lolzballs/esc204/README.md

# Praxis 3

This repository is intended to be the project management software for team T20 for ESC204 at the University of Toronto.

In addition, code related to controlling our robot is hosted here.
