lolzballs/esc204/cad/PrintFeb23rd/Component1.stl

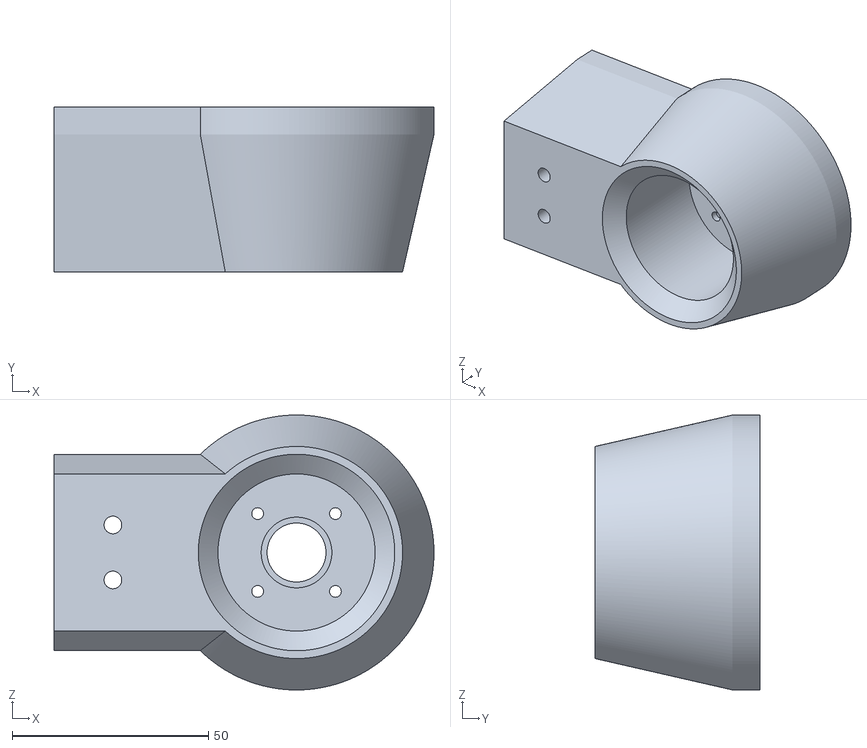
[picture p1: CAD file, 2020-03-02]
cad/PrintFeb23rd/Component1.stl
96.7 x 42.0 x 70.0
