lolzballs/esc204/cad/PrintMarch10th/TOFBracket v2.stl

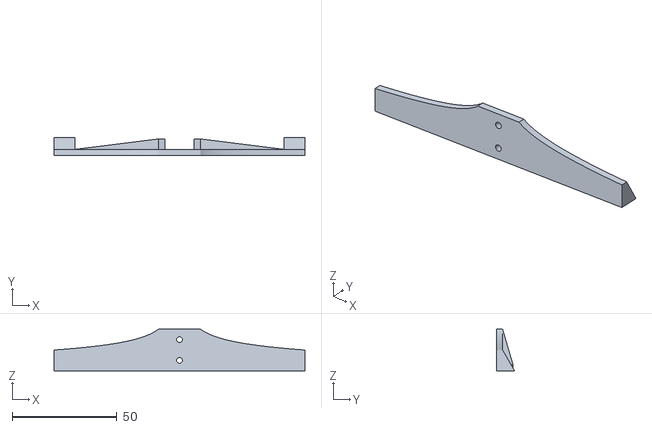
[picture p2: CAD file, 2020-03-11]
cad/PrintMarch10th/TOFBracket v2.stl
120.0 x 8.77 x 20.0
