lolzballs/esc204/cad/PrintMarch1st/JointBPartBv4.stl

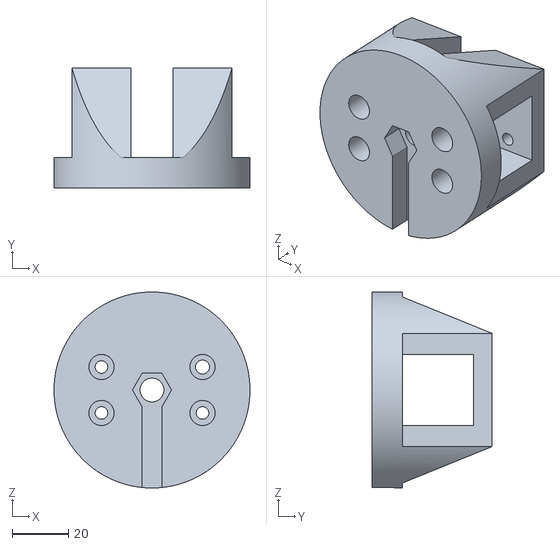
[picture p3: CAD file, 2020-03-02]
cad/PrintMarch1st/JointBPartBv4.stl
70.0 x 43.0 x 70.0
