lolzballs/esc204/cad/PrintMarch6th/JointBPartB v6.stl

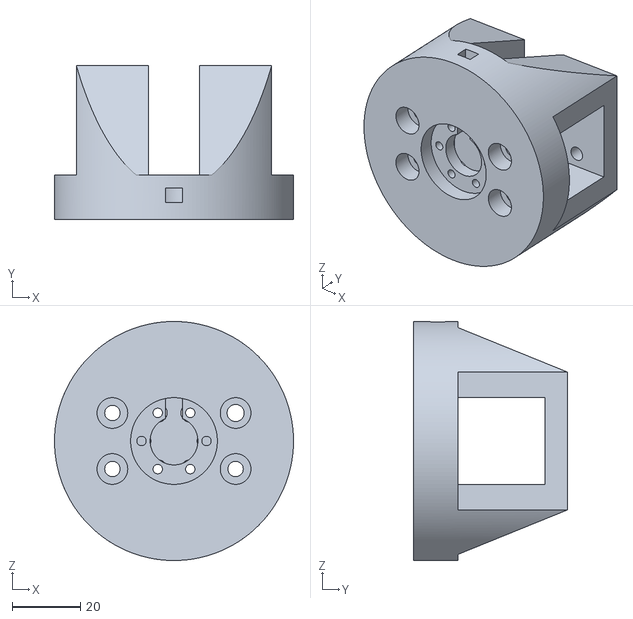
[picture p4: CAD file, 2020-03-06]
cad/PrintMarch6th/JointBPartB v6.stl
70.0 x 45.0 x 70.0
