lolzballs/esc204/cad/Protoboard_Mount v9.stl

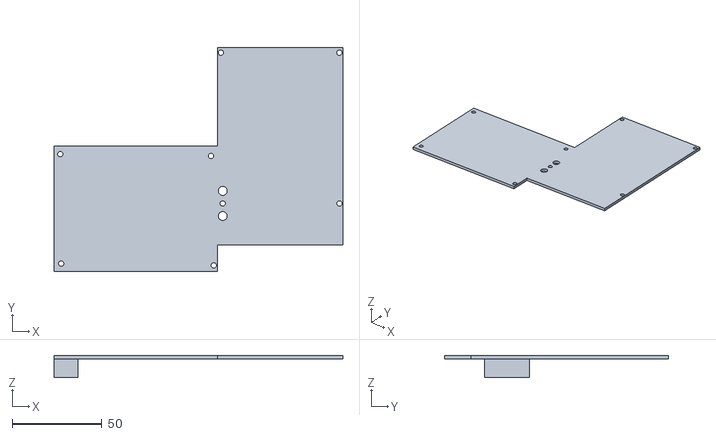
[picture p5: CAD file, 2020-03-04]
cad/Protoboard_Mount v9.stl
161.0 x 125.0 x 12.5
