lolzballs/esc204/cad/handleinterface.stl

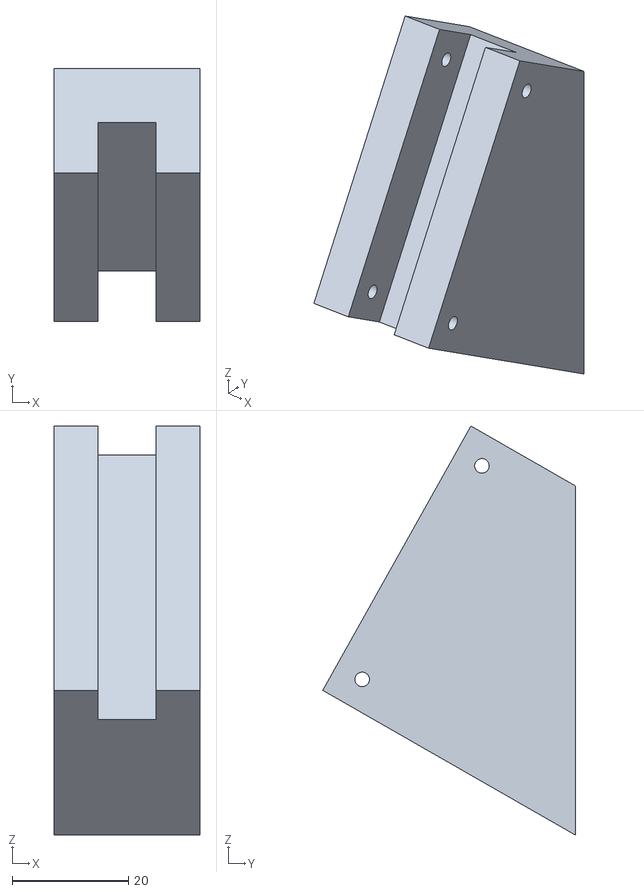
[picture p6: CAD file, 2020-03-02]
cad/handleinterface.stl
25.0 x 43.4 x 70.3
