lolzballs/esc204/cad/PrintFeb23rd/JointBPartB v4.stl

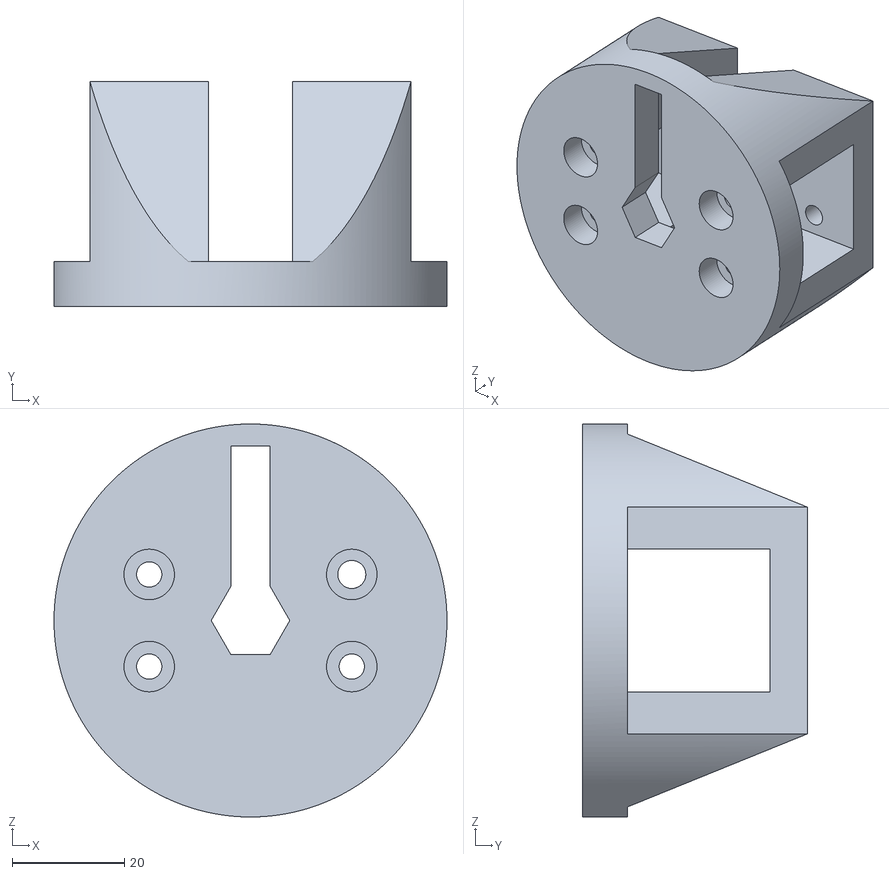
[picture p7: CAD file, 2020-03-02]
cad/PrintFeb23rd/JointBPartB v4.stl
70.0 x 40.0 x 70.0
