lolzballs/esc204/cad/PrintMarch1st/FANHolder.stl

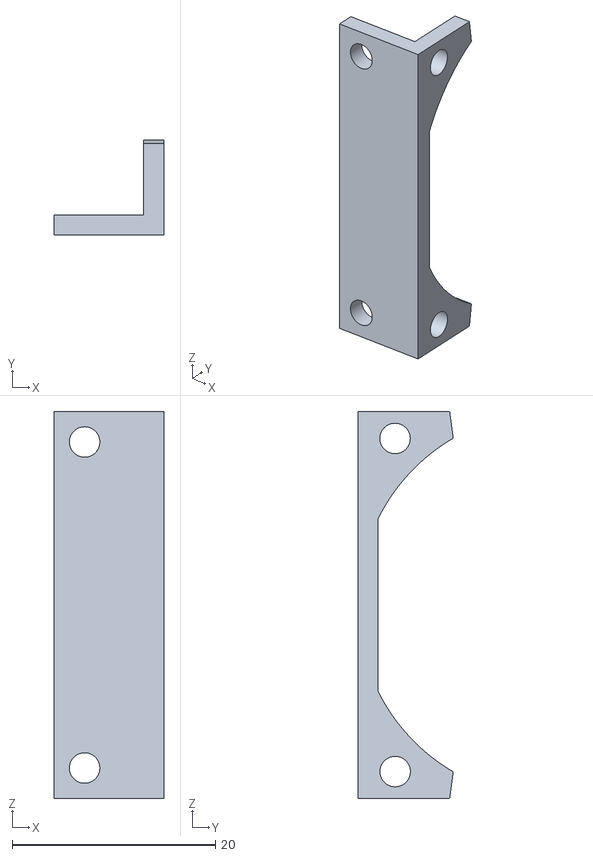
[picture p8: CAD file, 2020-03-02]
cad/PrintMarch1st/FANHolder.stl
10.8 x 9.40 x 38.1
