lolzballs/esc204/cad/PrintMarch2nd/JointBPartA v4.stl

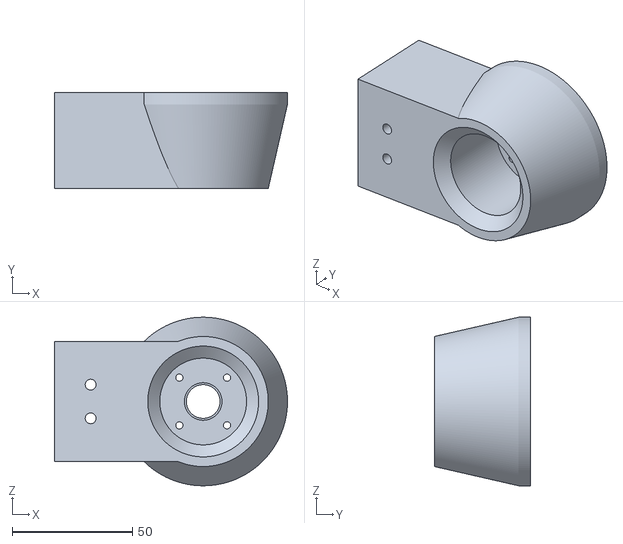
[picture p9: CAD file, 2020-03-03]
cad/PrintMarch2nd/JointBPartA v4.stl
96.7 x 40.0 x 70.0
