lolzballs/esc204/cad/PrintMarch6th/JointAInterface v4.stl

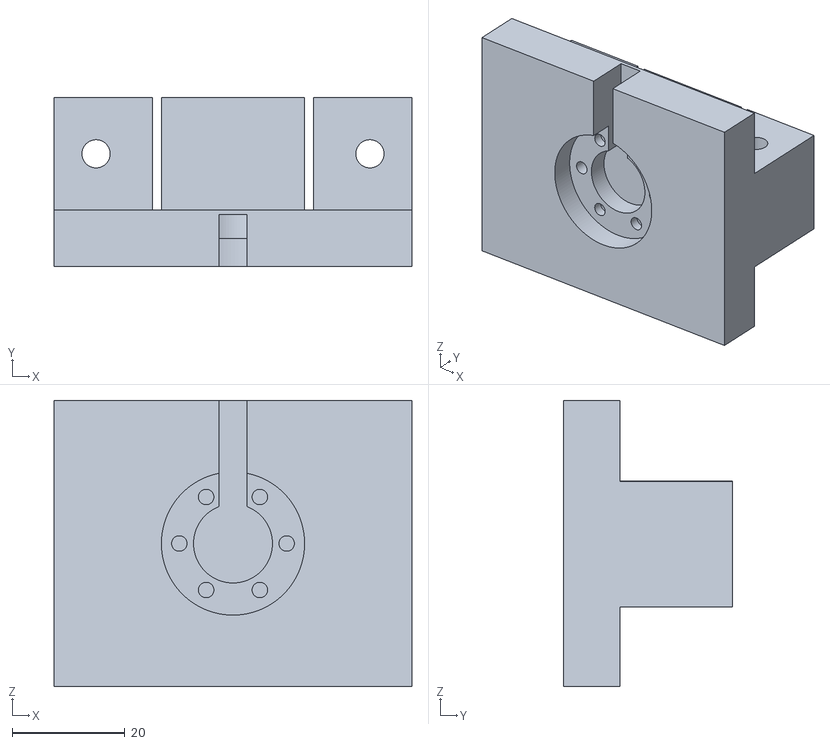
[picture p10: CAD file, 2020-03-06]
cad/PrintMarch6th/JointAInterface v4.stl
63.5 x 30.0 x 50.8
