lolzballs/esc204/cad/PrintFeb23rd/Body1.stl

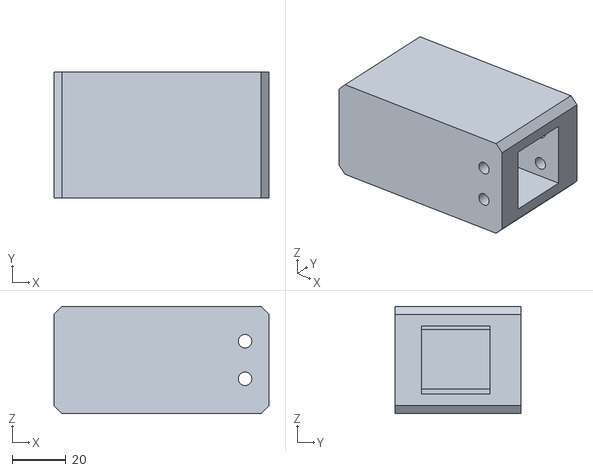
[picture p11: CAD file, 2020-03-02]
cad/PrintFeb23rd/Body1.stl
80.0 x 47.0 x 40.0
