lolzballs/esc204/cad/PrintMarch10th/CameraBracket2 v1.stl

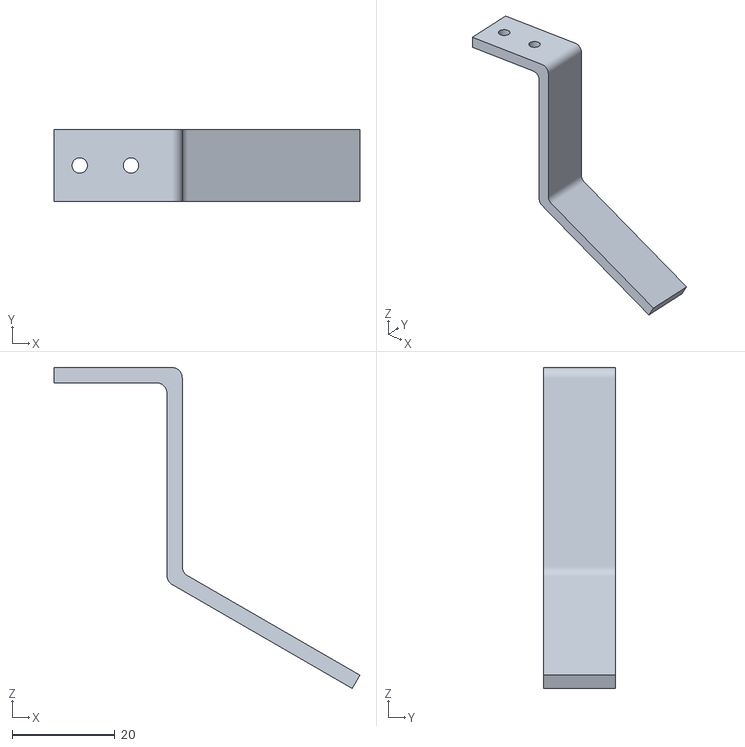
[picture p12: CAD file, 2020-03-11]
cad/PrintMarch10th/CameraBracket2 v1.stl
59.6 x 14.0 x 62.6
