lolzballs/esc204/cad/Bracket_Small_v1.stl

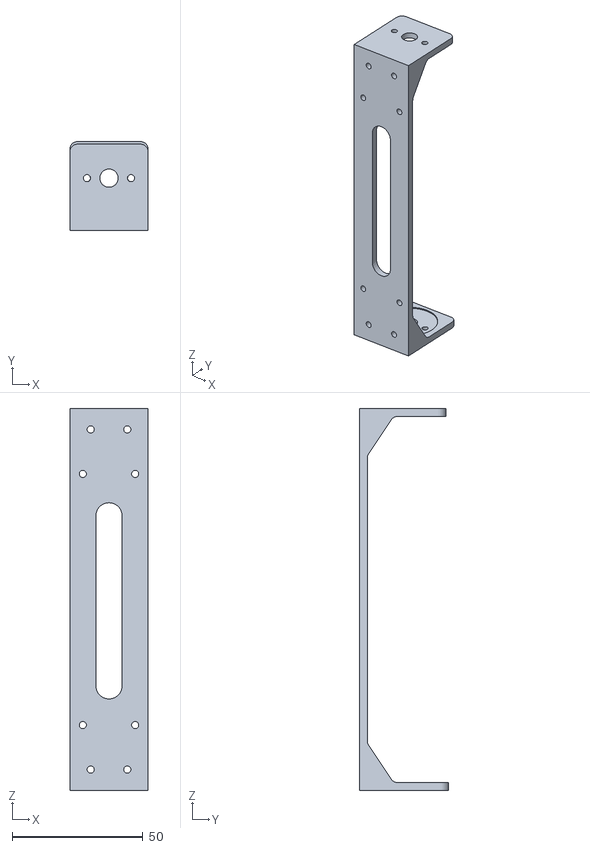
[picture p13: CAD file, 2020-03-02]
cad/Bracket_Small_v1.stl
30.0 x 34.0 x 146.0
