lolzballs/esc204/cad/PrintFeb23rd/JointAInterface v3.stl

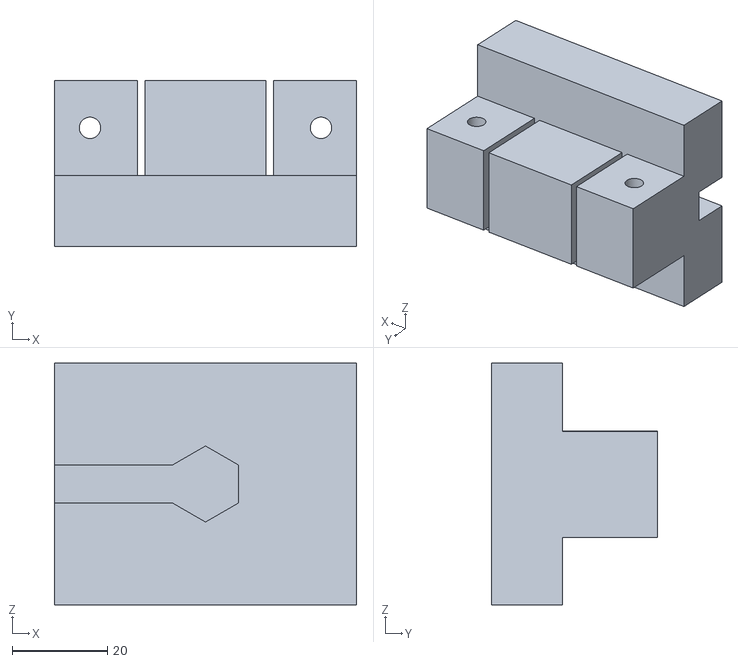
[picture p14: CAD file, 2020-03-02]
cad/PrintFeb23rd/JointAInterface v3.stl
63.5 x 35.0 x 50.8
