lolzballs/esc204/cad/PrintMarch10th/MotorBracket v1.stl

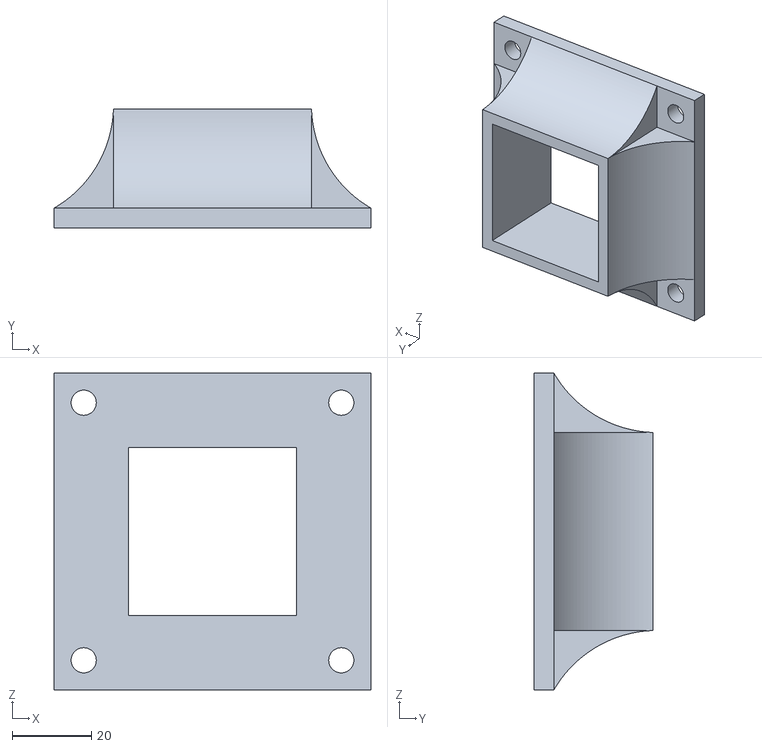
[picture p15: CAD file, 2020-03-11]
cad/PrintMarch10th/MotorBracket v1.stl
80.0 x 30.0 x 80.0
