lolzballs/esc204/cad/handlering.stl

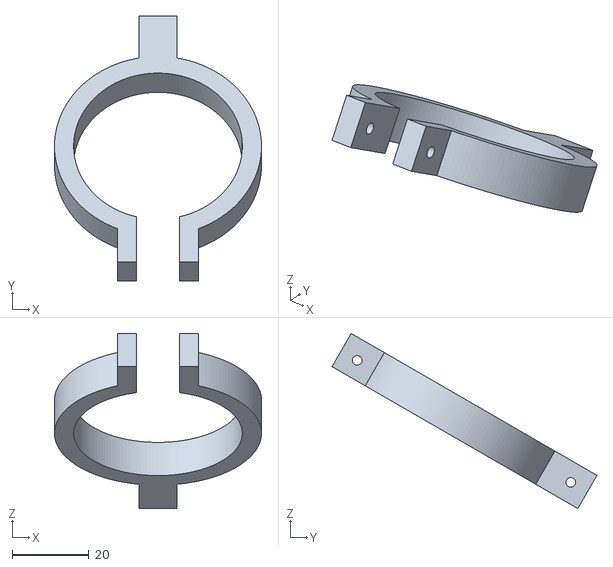
[picture p16: CAD file, 2020-03-02]
cad/handlering.stl
54.0 x 69.1 x 45.7
