lolzballs/esc204/cad/Power_Distribution_Case.stl

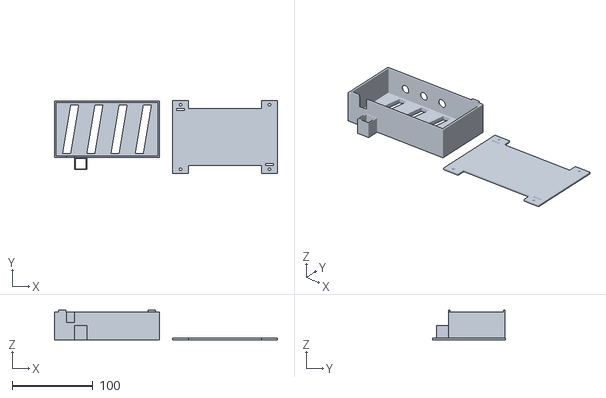
[picture p17: CAD file, 2020-03-02]
cad/Power_Distribution_Case.stl
276.1 x 90.0 x 36.7
