lolzballs/esc204/cad/JointBPartA.stl

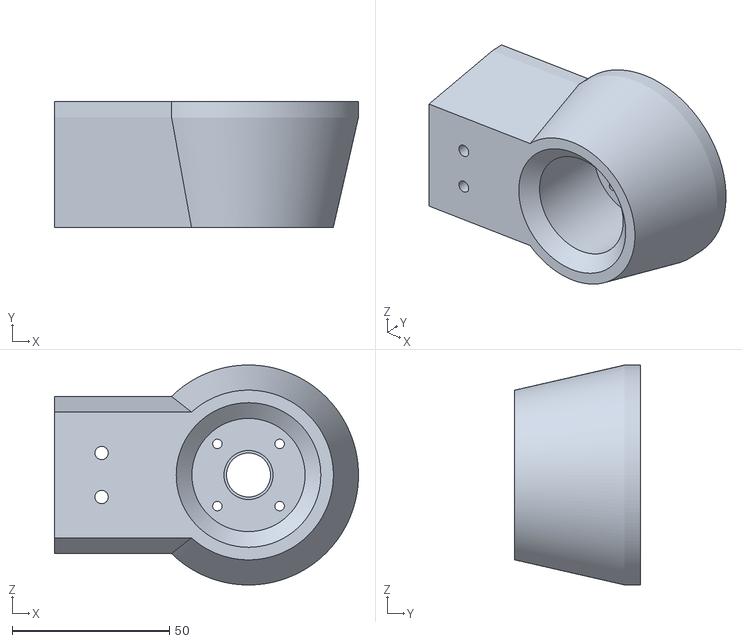
[picture p18: CAD file, 2020-03-02]
cad/JointBPartA.stl
96.7 x 40.0 x 70.0
