lolzballs/esc204/(list of files, cad)

Other CAD files:
cad/JointBPartB.stl
cad/PrintMarch10th/TOFBracket v1.stl
cad/PrintMarch2nd/JointAInterface v4.stl
cad/PrintMarch2nd/JointBPartB v6.stl
