lolzballs/esc204/(threads)

Thread 1 (2020-01-31):

Joint CAD

louisprimeau, 2020-01-31:
We need to do joint CAD, and detailed design decisions on the composition of those joints, i.e. 3D printed parts, bearings, etc.

- [x] CAD
- [x] 3D Printing

JonEsparaz, 2020-03-06:
@louisprimeau we need to modify the end-most joint's CAD to integrate the ToF sensors and camera.

JonEsparaz, 2020-03-10:
I’m going to close this issue in favour of opening a new one for CAD that can accommodate our sensors.

Closed 2020-03-10.

Thread 14 (2020-02-04):

End Effector CAD

louisprimeau, 2020-02-04:
Need to design the end effector to turn the switch on and off on the plug.

- [x] CAD
- [x] 3D Printing

louisprimeau, 2020-02-28:
Done btw

Closed 2020-02-28.

Thread 19 (2020-02-12):

Create nice wrappers for servos and steppers

lolzballs, 2020-02-12:
We want to be able to give high level commands to control the servos and steppers.

I'm thinking about having our high level logic in python, and the low-level drivers in individual C programs which can have commands sent to them through `stdio`.

JonEsparaz, 2020-02-25:
@lolzballs will `kinematics.py` interface with `commands.c`?

lolzballs, 2020-03-03:
Wrappers are done, so all that's left is the actual motion code.

Closed 2020-03-10.

Thread 22 (2020-02-19):

Power System

lolzballs, 2020-02-19:
We're using an Xbox One PSU, which provides 18A@12V and 1A@5V.

We are probably using the buck converters, since 1A can barely be used for anything.

- [x] Create power distribution board to derive power for steppers, servos and Pis
- [x] CAD enclosure
- [x] Print and install enclosure
- [x] Ensure all connections are :ok_hand:

Closed 2020-02-27.

Thread 24 (2020-02-20):

RBP camera exposure issue

JonEsparaz, 2020-02-20:
Currently the third-party RBP camera we are using requires ~ 10 seconds to properly expose an image.

Potential solutions:
- Use the genuine RBP camera (more expensive)
- Software fixes: https://projects.raspberrypi.org/en/projects/getting-started-with-picamera/7
- Live analysis from video (probably not feasible/possible)

JonEsparaz, 2020-02-28:
Conclusions after testing:
- Exposure is a non-issue if we direct light onto the test rig (requires <5 seconds)
- The OEM camera doesn't improve results
- Switching to a different colour (red or green) is likely better than blue since any windows appear blue.
- A better size filter for the rectangle detection will enure shapes in the background are not detected.

From TA: we have no guarantee of what the background will look like and won't be allowed to "calibrate" prior to testing.

JonEsparaz, 2020-03-02:
Small improvements to be made, but this specific issue is resolved.

Closed 2020-03-02.

Thread 27 (2020-03-10):

CAD for sensor mounting

JonEsparaz, 2020-03-10:
We need the mount camera and two ToF sensors. Also, not a sensor, but the second servo also needs to be mounted.

lolzballs, 2020-03-12:
The cad is complete and is printed. Just need to install now.

louisprimeau, 2020-03-12:
Cad was pushed yesterday.

Closed 2020-03-12.

Thread 28 (2020-03-10):

Motor shaft

JonEsparaz, 2020-03-10:
The set screws from our motor hubs are not sufficient to affix other components to the motor shaft (stepper motor).

lolzballs, 2020-03-10:
Since the motor hubs are circular I was thinking that rotating one of the two so that the set screw bites into the non-flat surface could help.

JonEsparaz, 2020-03-10:
I’m also wondering if we can 3D print a part that fills the empty space between the shaft and the one we wall of the hub with holes that the set screws fit into. I can CAD it up later to give you guys a better idea of what I’m thinking.

JonEsparaz, 2020-03-12:
Per in-person discussion, we are considering purchasing new stepper motors with a 6mm shaft, so that we can purchase 6mm D shaft hubs that won't slip.

lolzballs, 2020-03-12:
For now we will be using the mode of 25 missed steps to compensate. This is not ideal as we will likely be losing around 2 steps on a direction change in the base.
