lolzballs/esc204/main/milestone3.py

import kinematics
import camera

# wide scan to locate port

# align using tof w/ test rig

# move to fine scanning distance

# fine scan to centre w/ port

# check alignment

# if bad repeat alignment

# INDICATE THAT PORT HAS BEEN LOCATED

# deliver to front of port

# INDICATE THAT CHARGER HAS BEEN DELIVERED

# kill server power

# insert that mans (move forward)

# INDICATE THAT PORT HAS BEEN INSERTED

# wait at least 5 sec

# press release button

# return to starting location

def main():
