lolzballs/esc204/servo_test/servotest.py

import RPi.GPIO as GPIO
import time

servoPINA = 13
GPIO.setmode(GPIO.BCM)
GPIO.setup(servoPINA, GPIO.OUT)

pa = GPIO.PWM(servoPINA, 50) # GPIO 17 for PWM with 50Hz
pa.start(2.5) # Initialization
try:
  while True:
    pa.ChangeDutyCycle(5)
    time.sleep(0.5)
    pa.ChangeDutyCycle(7.5)
    time.sleep(0.5)
    pa.ChangeDutyCycle(10)
    time.sleep(0.5)
    pa.ChangeDutyCycle(12.5)
    time.sleep(0.5)
    pa.ChangeDutyCycle(10)
    time.sleep(0.5)
    pa.ChangeDutyCycle(7.5)
    time.sleep(0.5)
    pa.ChangeDutyCycle(5)
    time.sleep(0.5)
    pa.ChangeDutyCycle(2.5)
    time.sleep(0.5)
except KeyboardInterrupt:
  pa.stop()
  GPIO.cleanup()
