lolzballs/esc204/stepper_test/test.py

from time import sleep
import RPi.GPIO as GPIO

DIR = 31   # Direction GPIO Pin
STEP = 33  # Step GPIO Pin
CW = 1     # Clockwise Rotation
CCW = 0    # Counterclockwise Rotation
SPR = 48   # Steps per Revolution (360 / 7.5)

GPIO.setmode(GPIO.BCM)
GPIO.setup(DIR, GPIO.OUT)
GPIO.setup(STEP, GPIO.OUT)
GPIO.output(DIR, CW)

step_count = SPR
delay = .0208

for x in range(step_count):
    GPIO.output(STEP, GPIO.HIGH)
    sleep(delay)
    GPIO.output(STEP, GPIO.LOW)
    sleep(delay)

sleep(.5)
GPIO.output(DIR, CCW)
for x in range(step_count):
    GPIO.output(STEP, GPIO.HIGH)
    sleep(delay)
    GPIO.output(STEP, GPIO.LOW)
    sleep(delay)

GPIO.cleanup()
