lolzballs/esc204/(commit log)

2020-02-11 Servo motor test with python
2020-02-11 RBP camera test images
2020-02-11 Stepper driver test
2020-02-13 start of stepperd program
    This program is used for sending commands to the steppers.
    It will be interfaced through STDIN and STDOUT by the control program.
    This commit creates the basis, with an asynchronous design for reading
    commands from STDIN and a timer for timing stepper pulses.
2020-02-16 Created basic framework for commands
2020-02-19 Begin of tof_test
    Can change address of one tof sensor, so that
    two sensors can exist on one bus.
2020-02-19 servo testing
2020-02-22 implement actual stepper driving functionality
    very not tested so please don't take it for granted
2020-02-25 Blueprint of kinematics
2020-02-28 add some comments to stepperd
2020-02-29 start servo and stepper wrappers in python
2020-03-01 stepperd works
2020-03-01 calibration for joint servo
    also flush messages after writing
2020-03-01 update calibration parameters
2020-03-01 forward and inverse kinematics
2020-03-02 Uploading all previously designed stl files.s
    [Body1.stl, Bracket_Small_v1.stl, Component1.stl, FANHolder.stl, JointAInterface v3.stl, JointBPartA.stl, JointBPartB v4.stl, JointBPartB.stl]
2020-03-02 fix class, add to main
    [camera.py]
2020-03-02 add ShapeDetector to camera.py
2020-03-02 close camera
2020-03-02 stepperd: configure sets timer interval
2020-03-02 main: strip bytes from stepperd stdout
2020-03-02 enable print for debugging
2020-03-03 New Prints March 2nd, fixed bearing dimensions, added set screw interface features on Joint A & Joint B
    [JointAInterface v4.stl, JointBPartA v4.stl, JointBPartB v6.stl]
2020-03-04 protoboard mount
    [Protoboard_Mount v9.stl]
2020-03-06 kinematics: basic movement code
2020-03-06 Prints from March 6th, fixed screw hub models
    [JointAInterface v4.stl, JointBPartB v6.stl]
2020-03-09 stepperd: short-circuit when currently on target steps
    previously when a set command is sent with its target the same as
    the current, the motors will spin continously
    [commands.c, main.c]
2020-03-09 kinematics: update start calibration and check ranges
    the start position is now horizontal with the correct angles (0, 0, 0)
    [kinematics.py]
2020-03-09 kinematics: rotate phi
2020-03-11 More prints
    [CameraBracket2 v1.stl, MotorBracket v1.stl, TOFBracket v1.stl]
2020-03-11 fixed TOFBracket -> v2
    [TOFBracket v2.stl]
2020-03-12 get user input, return of camera.py now tuple
2020-03-13 fix array capture (maybe)
    [camera.py]
2020-03-13 idk what's wrong. arrays are bad for cv.
    [camera.py]
2020-03-13 revert to working version
    [camera.py]
2020-03-16 clean up camera code
